UzkiS/rpi-envsys/(commit log)

2019-12-20 add arduino
2020-01-21 change thread parameter;
2020-05-26 add PCB and Schematic.
